cataxel/ProyectoTanque/(threads)

Thread 2 (2024-04-09):

Reunión encargados de diseño, programación y electrónica

VeroBarragan18, 2024-04-09:
-Primer avance de diseño
-Listado de materiales a necesitar
-Solicitud de los materiales al laboratorio de electrónica
-Resolución de dudas y depuración

Closed 2024-04-09.

Thread 3 (2024-04-09):

Reunión de encargados de electrónica, diseño y programación

VeroBarragan18, 2024-04-09:
-Ensamblado y planeación
-Listado de materiales necesarios
-Ir por ellos al laboratorio
-Resolución de sotuaciones emergentes
-Hacer un recuento de actividades de programación Unity terminadas:

1. Conexión de hardware: Camaras
2. Primera presentación del GameObject

Closed 2024-04-23.

Thread 4 (2024-04-09):

seleccion de tanque

cataxel, 2024-04-09:
buscar y seleccionar un tanque a usar en el proyecto

mruvalcaba02, 2024-04-10:
El tanque esta dividido en 2 partes una seria la parte del carrito y otra la parte de la torreta, anexo imágenes del diseño del tanque seleccionado.

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

Closed 2024-04-16.

Thread 6 (2024-04-16):

Movimiento del tanque

cataxel, 2024-04-16:
programar el movimiento del tanque, usando las teclas 'w' para moverse hacia adelante, 's' para moverse hacia atrás, 'a' para girar el tanque a la izquierda y 'd' para girar el tanque a la derecha

el tanque girara de la siguiente forma:
al girar a la izquierda la oruga izquierda del tanque se detendrá o bajara su velocidad y la oruga derecha acelerara
se va a hacer lo mismo al girar a la derecha, la oruga derecha se detendrá o bajara su velocidad mientras la oruga izquierda acelerara

estas acciones se enviaran de unity al arduino y el arduino hará toda la funcionalidad del giro

en el juego móvil se usaran botones en la pantalla que simularan los mismos procesos de presionado de teclas

Closed 2024-08-17.

Thread 7 (2024-04-16):

Agregar 2 vistas de camara

cataxel, 2024-04-16:
se tiene que agregar 2 vistas de cámara, una que muestre un panorama general y otra que muestre una mira (recortando la imagen de forma circular enfocándola en un punto)

la camara de mira debe poder hacer un pequeño zoom en la imagen

Closed 2024-04-22.

Thread 8 (2024-04-16):

Reticulo de mira

cataxel, 2024-04-16:
se tiene que actualizar el retículo de mira para que su grosor sea menor y que solo se muestre con la cámara de mira

ademas de agregar a un lado del retículo vertical un medidor, para medir la distancia de los objetivos a disparar

la mira se activara al hacer click izquierdo del raton

Closed 2024-04-22.

Thread 13 (2024-04-30):

Menu de inicio

cataxel, 2024-04-30:
Se tiene que crear un menú de inicio con lo siguiente

> botón de play, la cual mandara a la escena de juego
> botón de opciones, se usara para modificar diferentes aspectos del juego
> botón salir, este boton cerrara el juego

*** Agreguen diferentes botones  de ser necesario ***

Closed 2024-08-17.

Thread 14 (2024-04-30):

Clase electrónica

VeroBarragan18, 2024-04-30:
Aprovechando que las siguientes dos horas el horario de practicamente todos coincide con la clase de sistemas programables, aprovecharemos para:
Objetivos:
- Lograr la conexión rx y tx en arduino (conexión unity arduino)
- hacer la conexión de la pila entre arduino wifi y los motores
- Entrega de partes ya impresas para su posterior pintura y caracterización
Favor de compartir ideas y puntos al prinicipio entre todos y luego con sis respectivos equipos. Además de recabar evidencias de sus avances
Gracias

Closed 2024-05-02.

Thread 15 (2024-05-02):

*AVANCE DE CLASE*

VeroBarragan18, 2024-05-02:
Hoy se trabajó en la conexion rx y tx de una tarjeta arduino y la modulo wifi sp8266
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

Esta es la lista de materiales que aún se necesitan:
- 2 motores
- jumpers
- servos
- Camara
- Cable para hacer las soldaduras

Los objetivos de la siguiente reunión son hacer el diseño del circuito (Electrónicos y encargado de impresión 3d), revisar los avances y requerimientos de los programadores y Comenzar a armar el cirucuito (Lo más básico: tierras y correintes, soldadura de jumpers y cables) así mismo, los materiales serán pedidos en el laboratorio en ese orden para evitar tener más material del que necesitamos

Thread 16 (2024-05-03):

ESP32

VeroBarragan18, 2024-05-03:
Buenos días a todos, quería comentarles una nueva adición al proyecto. El profesor Dalet nos ha prestado una Esp32 para conectarla a arduino y lograr la comunicación a distancia. El objetivo es comenzar a implementarla el lunes. Por ahora se implementará esta información:
ESP32 es la denominación de una familia de [chips SoC](https://es.wikipedia.org/wiki/System_on_a_chip) de bajo coste y consumo de energía, con tecnología [Wi-Fi](https://es.wikipedia.org/wiki/Wifi) y [Bluetooth](https://es.wikipedia.org/wiki/Bluetooth) de modo dual integrada. El ESP32 emplea un microprocesador Tensilica Xtensa LX6 en sus variantes de simple y doble núcleo e incluye interruptores de antena, [balun](https://es.wikipedia.org/wiki/Balun) de radiofrecuencia, amplificador de potencia, amplificador receptor de bajo ruido, filtros, y módulos de administración de energía. El ESP32 fue creado y desarrollado por [Espressif Systems](https://es.wikipedia.org/w/index.php?title=Espressif&action=edit&redlink=1) y es fabricado por [TSMC](https://es.wikipedia.org/wiki/TSMC) utilizando su proceso de 40 nm.[1](https://es.wikipedia.org/wiki/ESP32#cite_note-EspressifESP32ProductPage-1)  Es un sucesor de otro SoC, el [ESP8266](https://es.wikipedia.org/wiki/ESP8266).
Así mismo adjuntaré un script en unity de cómo hacer la conexión
using UnityEngine;
using System.IO.Ports;

public class ESP32Controller : MonoBehaviour
{
    public string portName = "COM3"; // Puerto COM al que está conectado el ESP32
    public int baudRate = 9600; // Velocidad de baudios
    private SerialPort serialPort;

    void Start()
    {
        serialPort = new SerialPort(portName, baudRate);
        serialPort.Open(); // Abre el puerto serial

        // Asegúrate de que el puerto serial está abierto antes de comenzar a escribir o leer
        if (serialPort.IsOpen)
        {
            Debug.Log("Puerto serial abierto");
        }
        else
        {
            Debug.LogError("Error al abrir el puerto serial");
        }
    }

    void Update()
    {
        // Aquí puedes leer o escribir datos al ESP32
        // Ejemplo:
        // serialPort.WriteLine("Hello ESP32!");
        // string response = serialPort.ReadLine();
        // Debug.Log("Respuesta del ESP32: " + response);
    }

    void OnDestroy()
    {
        serialPort.Close(); // Cierra el puerto serial cuando el script se destruye
    }
}
y otro en arduino
#include <SoftwareSerial.h>

#define RX_PIN 2 // Pin RX del ESP32
#define TX_PIN 3 // Pin TX del ESP32
#define BAUD_RATE 9600 // Velocidad de baudios

SoftwareSerial espSerial(RX_PIN, TX_PIN);

void setup() {
  Serial.begin(BAUD_RATE); // Inicializa el puerto serial de Arduino
  espSerial.begin(BAUD_RATE); // Inicializa el puerto serial del ESP32
}

void loop() {
  if (espSerial.available()) { // Verifica si hay datos disponibles para leer del ESP32
    String command = espSerial.readStringUntil('\n'); // Lee el comando del ESP32
    Serial.println("Comando recibido desde ESP32: " + command);

    // Aquí puedes agregar tu lógica para procesar los comandos recibidos del ESP32
    // Ejemplo:
    // if (command.equals("LED_ON")) {
    //   digitalWrite(LED_PIN, HIGH);
    // } else if (command.equals("LED_OFF")) {
    //   digitalWrite(LED_PIN, LOW);
    // }
  }
}

Closed 2024-05-09.

Thread 18 (2024-05-09):

Avence y horario

VeroBarragan18, 2024-05-09:
Buenas tardes. Adjunto la evidencia del armado de las orugas además de las primeras pruebas de corriente con una bateria temporal, esperamos terminar los circuitos el lunes para poder pasar  a la pintura y posterior carga del código, pruebas y depuración

https://github.com/cataxel/ProyectoTanque/assets/99703490/e8f2e8c5-0efb-445a-87bc-39068f7f3615

Closed 2024-05-09.

Thread 19 (2024-05-09):

Planeación

VeroBarragan18, 2024-05-09:
Compañeros, está lista una planeación general del proyecto tomando en cuenta los objetivos logrados en la última semana. El avance está registrado en issues de GitHub con fotos y videos, además de actualizaciones de código. A este punto, estamos llegando a el "armado" del prototipo. Todas las fases individuales está culminándose y estamos casi listos para echar a andar el prototipo, darle presentación y hacer pruebas y depuración, para lo cuál, tendremos aproximadamente dos semanas para aprovehcar y pulirlo. En hora buena, hemos llegado al 50% del proyecto. Muchas gracias, adjunto el documento
[Actividad 4.3.xlsx](https://github.com/cataxel/ProyectoTanque/files/15257180/Actividad.4.3.xlsx)

Thread 22 (2024-05-14):

Avances al 13 de Marzo del 2024

VeroBarragan18, 2024-05-14:
Los avances hechos hasta el 13 de marzo están en las actualizaciones pasadas, sin embargo, el resumen general es el siguiente:
- Conexión de las tarjetas y su configuración para conectarse a wifi
- Los motores están corriendo con la batería
- Se terminó la impresión de las orugas
Esta semana se pretende hacer pruebas de la velocidad de los motores, y armado del tanque, para pruebas reales. Por otro lado ya se está trabajando en la pintura, se decidió un color militar con otros subtonos igualmente militares
El armado de las orugas a representado un gasto compartido que por ahora ha sido cubierto con la tarjeta de un par de integrantes, así que por cada persona se cooperarán $106 pesos que podemos ir depositando a la cuenta: 646470146403273599. Lo que se ha adquirido han sido baleros y una bateria, además de motores más convenientes.
Las actividades para mañana es seguir con armado y conexiones. Necesitamos discutir el pulido o lijado de las superficies del tanque, además de el método de disparo. La planeación del proyecto la dejo adjunta a esta publicación.
Por otro lado, dejo aquí las evidencias de lo que hemos estado haciendo, espero a alguien le funcionen para sus redes sociales. Aún hace falta nombrar al tanque, así que es conveniente que cada quién piense en un nombre (videojuego y tanque, o ambos por separado)
Mañana tenemos una hora para avanzar!
[Planeación.ods](https://github.com/cataxel/ProyectoTanque/files/15301177/Planeacion.ods)
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

https://github.com/cataxel/ProyectoTanque/assets/99703490/7e2c055f-9f8a-4d83-9b73-bacdbbdc6fb7

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

Mañana agregamos al repositorio a los nuevos integrantes

Thread 25 (2024-05-20):

ESP32

VeroBarragan18, 2024-05-20:
El equipo de programación acaba de calibrar la ESP32 en la primera de las dos orugas, ademas de los casos de movimiento de los motores

https://github.com/cataxel/ProyectoTanque/assets/99703490/d0b4f824-f5df-4140-b001-c987409ae942

Mañana vamos a tratar:
- Pulido de las piezas
- Pintura
- Motor del cañón

Thread 26 (2024-05-22):

Avances semanales

VeroBarragan18, 2024-05-22:
En los siguientes issues vamos abarcar por separado los avances de los últimos días
Comenzamos con el final de las pruebas de los motores de las orugas y la ESP32, al final, se completó la etapa y se pudo pasar a la compra de los motores de disparo de los proyectiles.
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

Thread 27 (2024-05-22):

Pintura y armado

VeroBarragan18, 2024-05-22:
Se terminaron de imprimir las piezas faltantes y todas fueron a pintarse:
Se escogieron los colores de las tropas de carga del ejército mexicano Sentinel.
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
Adjuntamos evidencia de la pintura de las piezas
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

https://github.com/cataxel/ProyectoTanque/assets/99703490/e4c6eb7e-67f2-439b-9164-63d3cabef2d2

Thread 29 (2024-05-22):

Conexión de la cámara

VeroBarragan18, 2024-05-22:
El diseño del cuerpo del tanque tiene características para implementar una cámara arduino, la cual será visible desde el entorno de Unity:
Por el momento se está implementando la conexión con este diagrama, y sus respectivas modificaciones al vuelo
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
Por otro lado, el compartir imagen entre Arduino y Unity
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

Thread 30 (2024-05-22):

Documentación y avances finales

VeroBarragan18, 2024-05-22:

VeroBarragan18, 2024-05-22:
Hoy también se trabajó en la documentación, entre todo se alcanzaron estos avances
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
Las piezas ya disponibles a las 11 am son estas:
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
El día jueves se prevé tener pintado el cuerpo y seleccionados los tornillos
Documentación disponible en GitHub
[Planeación.ods](https://github.com/cataxel/ProyectoTanque/files/15406627/Planeacion.ods)

Thread 32 (2024-05-26):

Motores

VeroBarragan18, 2024-05-26:
El día viernes 24 de Mayo los motores han corrido saisfactoriamente

https://github.com/cataxel/ProyectoTanque/assets/99703490/7e5c34de-29fe-4171-afc3-cc20e34fc373

El lunes comenzaremos con:
- La conexión de la cámara
- Debate sobre piezas que pueden mejorar el proceso, como una ESP32 con cámara
- Finales de la conexión con baterías
- Soldado de cables y cambio de jumpers arduino por cables
Con respecto a los motores que dispararán los proyectiles, lamentablemente el proovedor canceló la compra que ya estaba en camino.
Mañana debatiremos alternativas para el producto, costos y en general, también otras posibles soluciones al problema. Ninguna plataforma de ventas en línea cubre envíos antes de esta semana, así que la búsqueda sigue, y está en marcha

Thread 33 (2024-05-27):

Avance 27 de Mayo 2024 ESP32 con cámara

VeroBarragan18, 2024-05-27:
El día de hoy, nos encontramos en el laboratorio de electrónica. Ha llegado la ESP32-CAM: Esta es una ESP32 como la que estábamos trabajando las ultimas dos semanas, pero con Cámara. Con este nuevo componente vamos a simplificar la conexión y configuración programable de la OV7670 Arduino. Es esta:
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
Hoy se comenzará su implementación de tiempo real en Unity
Por otro lado, comenzamos el soldado de los cables:
Con el fin de hacer las conexiones más estables, más prácticas de espacio y útiles, se van a ir reemplazando los jumpers Arduino por cable, que cortaremos con respecto a las necesidades y soldaremos en función. Ya se han comenzado las primeras labores
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
Con respecto a la pieza defectuosa, se están haciendo los reclamos pertinentes en mercado libre. La documentación sigue en curso.
**Se le pide a todas las personas que han hecho las compras de componentes por internet que se reporten al laboratorio, o adjunten en este issue los costos de lo que han comprado, lo que han comprado, y las fechas en que se compró y se recibió, para comenzar a gregarlo a documentación como costos, a planificación y realizar el cronograma de actividades final, además de sacar cuentas e ir finiquitando todos nuestras cooperaciones**

Thread 34 (2024-05-28):

Actualización

VeroBarragan18, 2024-05-28:
Los servomotores que mueven el ángulo de disparo del proyectil ya han funcionado, después de implementar un segundo servo para que pudiera mover toda la parte superior del tanque

https://github.com/cataxel/ProyectoTanque/assets/99703490/0ff8e153-0cab-4ac5-9771-31b69b4125cb

Mañana seguiremos con el disparo y conexión de ESP32-CAM, soldado y armado

Thread 35 (2024-05-29):

Actualización del 28 de Mayo del 2024

VeroBarragan18, 2024-05-29:
El día de hoy se siguió trabajando en el tanque, los avances fueron los siguientes:
-Se está por terminar el alambrado provicional, así que se podrá seguir mañana con el soldado. Hoy se instalaron 4 tubos termoretráctiles para cubrir el cable de los motores
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

- Se siguió la documentación: se agregaron los pasos que estamos abordando, además de costos y videncias de las compras por internet para el proyecto. Solo adjuntaré dos
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
El tanque es capaz ya de disparar con poca fuerza proyectiles y mover la trayectoria del espacio

VeroBarragan18, 2024-05-29:
Adjunto el cronograma y la planeación hasta el momento
[Planeación.ods](https://github.com/cataxel/ProyectoTanque/files/15477105/Planeacion.ods)

fapayan, 2024-06-10:
Evaluados
_____________________________________________________________________________________________________
Ing. Fco. Armando Payan GuerreroDocente del Área de Ingeniería en Sistemas ComputacionalesINSTITUTO TECNOLÓGICO DE JIQUILPAN 

    El martes, 28 de mayo de 2024, 06:12:01 p. m. CST, VeroBarragan18 ***@***.***> escribió:

Adjunto el cronograma y la planeación hasta el momento
Planeación.ods

—
Reply to this email directly, view it on GitHub, or unsubscribe.
You are receiving this because you were assigned.Message ID: ***@***.***>

Thread 36 (2024-06-04):

Actualización final

VeroBarragan18, 2024-06-04:
Hoy terminan las pruebas de Tank-esito. Mañana es la exposición final. El código está listo en la plataforma, adjunto el Excel con las hojas de cálculo necesarias
[Uploading Planeación.ods…]()

mruvalcaba02, 2024-06-05:
https://drive.google.com/drive/folders/1CZdM1xjKfboabJFa5A5HZ0tTONdmHFQ_?usp=drive_link

Thread 38 (2024-06-05):

Fotos Tank-ecito

CristianG1172002, 2024-06-05:
Fotografías del tanque finalizado

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

https://github.com/cataxel/ProyectoTanque/assets/154762125/c1e1f300-386a-47bc-af52-01aeb9e30e47

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

https://github.com/cataxel/ProyectoTanque/assets/154762125/e6b06418-af56-4bfe-b840-9b874235546c
