cataxel/ProyectoTanque/(commit log)

2024-04-16 integracion de camara
2024-04-17 Se agrego el script mira
    mira
2024-04-22 zoom y reticula
    se agrego el zoom con efecto de mira circular al dar click derecho con el cambio de reticula para calcular distancias y el viento.
2024-04-29 carpetas
    se crearon carpetas para documentacion de imagenes
2024-05-14 actualizacion conexion ESP32 y arduino
2024-05-15 control de motor con arduino y drive motor sheeld
